quisqueya/ESP8266-GPIO-Extender/multiplexer-8-analog-8-digital-inputs/multiplexer-CD74HC4067-16-lines.h

#ifndef MULTIPLEXER_CD74HC4067_16_LINES_H
#define MULTIPLEXER_CD74HC4067_16_LINES_H
 
#include <Arduino.h>


class MultiAnalogDigitalRead{
private:
    
    bool initialized;
    void setAddress(int pinNumber, bool digital);

    // *** D0 ==> LOW = analog read select; HIGH = digital read select
    const int selectPin = D0;
    const int analogReadPin = A0;
    const int digitalReadPin  = D8;  // data pin
    const int addressPins0 = D1;
    const int addressPins1 = D2;
    const int addressPins2 = D4;  //Address pins A0, A1, A2      
public:
    MultiAnalogDigitalRead();
    ~MultiAnalogDigitalRead();

    void begin();
    int readDigital(int pin);
    int readAnalog(int pin);
    
    // static public
    static bool enableSerialMonitor;
};
 
#endif MULTIPLEXER_CD74HC4067_16_LINES_H
